plietar/light-control/hardware/light-control.kicad_pcb

## KiCad design hardware/light-control.kicad_pcb (2024-10-11)

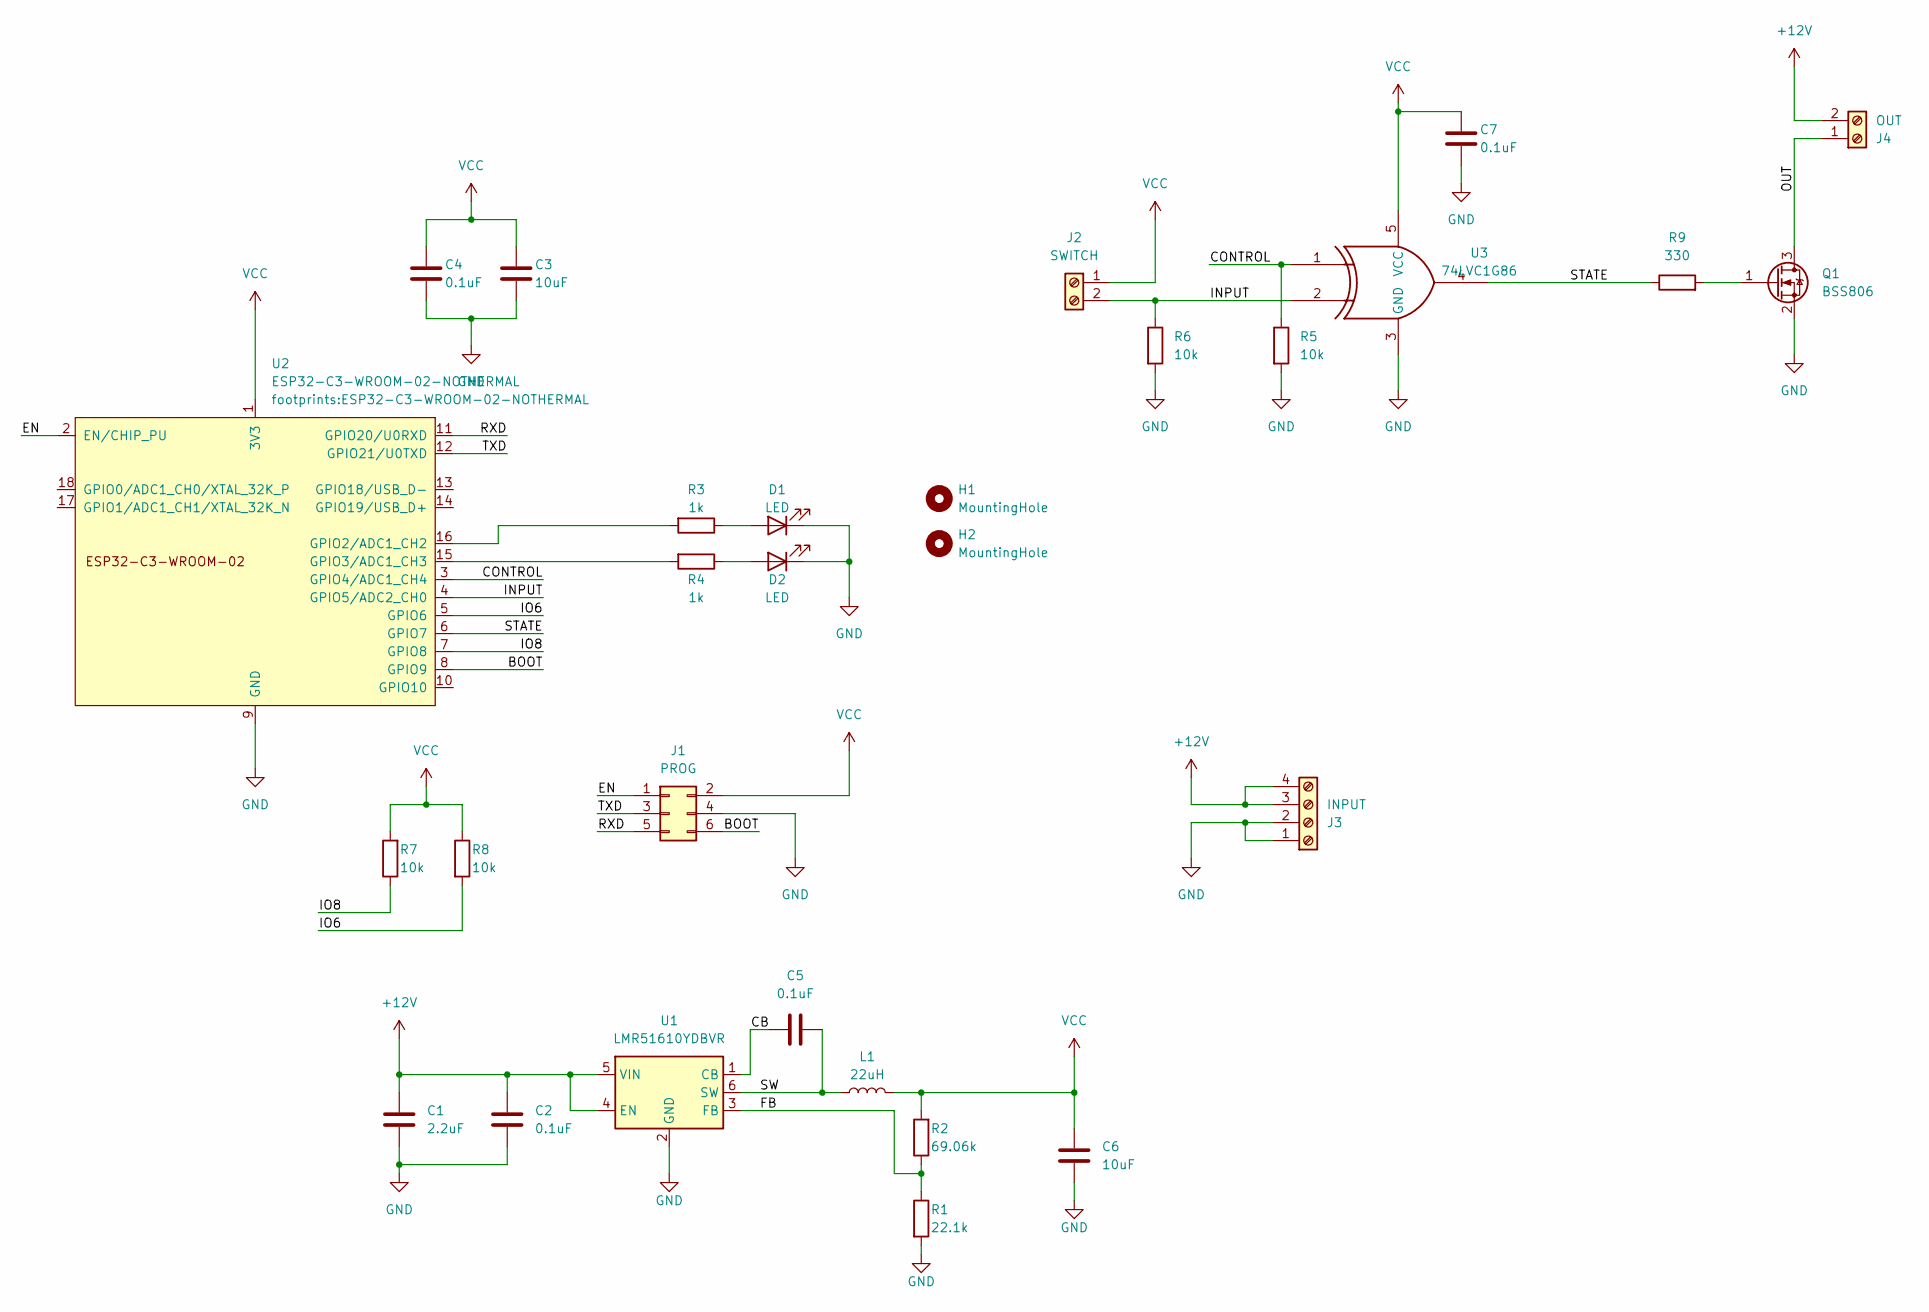
[picture p1: schematic light-control.kicad_sch]

Parts:
C1: 2.2uF; C_1206_3216Metric_Pad1.33x1.80mm_HandSolder
C2, C4, C5, C7: 0.1uF; C_1206_3216Metric_Pad1.33x1.80mm_HandSolder
C3: 10uF; C_1206_3216Metric_Pad1.33x1.80mm_HandSolder
C6: 10uF; C_1210_3225Metric_Pad1.33x2.70mm_HandSolder
D1, D2: LED; LED_1206_3216Metric_Pad1.42x1.75mm_HandSolder
H1, H2: MountingHole; MountingHole_2.2mm_M2
J1: PROG; Tag-Connect_TC2030-IDC-NL_2x03_P1.27mm_Vertical
J2: SWITCH; TerminalBlock_Phoenix_PT-1,5-2-3.5-H_1x02_P3.50mm_Horizontal
J3: INPUT; TerminalBlock_Phoenix_PT-1,5-4-3.5-H_1x04_P3.50mm_Horizontal
J4: OUT; TerminalBlock_Phoenix_PT-1,5-2-3.5-H_1x02_P3.50mm_Horizontal
L1: 22uH; L_TDK_VLS6045EX_VLS6045AF; Part number VLS6045EX-220M
Q1: BSS806; SOT-23_Handsoldering
R1: 22.1k; R_1206_3216Metric_Pad1.30x1.75mm_HandSolder
R2: 69.06k; R_1206_3216Metric_Pad1.30x1.75mm_HandSolder
R3, R4: 1k; R_1206_3216Metric_Pad1.30x1.75mm_HandSolder
R5, R6, R7, R8: 10k; R_1206_3216Metric_Pad1.30x1.75mm_HandSolder
R9: 330; R_1206_3216Metric_Pad1.30x1.75mm_HandSolder
U1: LMR51610YDBVR; SOT-23-6
U2: ESP32-C3-WROOM-02-NOTHERMAL
U3: 74LVC1G86; SOT-23-5_HandSoldering

Connections:
+12V: C1.1, C2.1, J3.3, J3.4, J4.2, U1.4 (EN), U1.5 (VIN)
/BOOT: J1.6, U2.8 (GPIO9)
/CB: C5.1, U1.1 (CB)
/CONTROL: R5.1, U2.3 (GPIO4/ADC1_CH4), U3.1
/EN: J1.1, U2.2 (EN/CHIP_PU)
/FB: R1.1, R2.1, U1.3 (FB)
/INPUT: J2.2, R6.1, U2.4 (GPIO5/ADC2_CH0), U3.2
/IO6: R8.2, U2.5 (GPIO6)
/IO8: R7.1, U2.7 (GPIO8)
/OUT: J4.1, Q1.3 (D)
/RXD: J1.5, U2.11 (GPIO20/U0RXD)
/STATE: R9.1, U2.6 (GPIO7), U3.4
/SW: C5.2, L1.1, U1.6 (SW)
/TXD: J1.3, U2.12 (GPIO21/U0TXD)
GND: C1.2, C2.2, C3.2, C4.2, C6.2, C7.2, D1.1 (K), D2.1 (K), J1.4, J3.1, J3.2, Q1.2 (S), R1.2, R5.2, R6.2, U1.2 (GND), U2.9 (GND), U3.3 (GND)
unnamed: D1.2 (A), R3.1
unnamed: D2.2 (A), R4.1
unnamed: Q1.1 (G), R9.2
unnamed: R3.2, U2.16 (GPIO2/ADC1_CH2)
unnamed: R4.2, U2.15 (GPIO3/ADC1_CH3)
VCC: C3.1, C4.1, C6.1, C7.1, J1.2, J2.1, L1.2, R2.2, R7.2, R8.1, U2.1 (3V3), U3.5 (VCC)

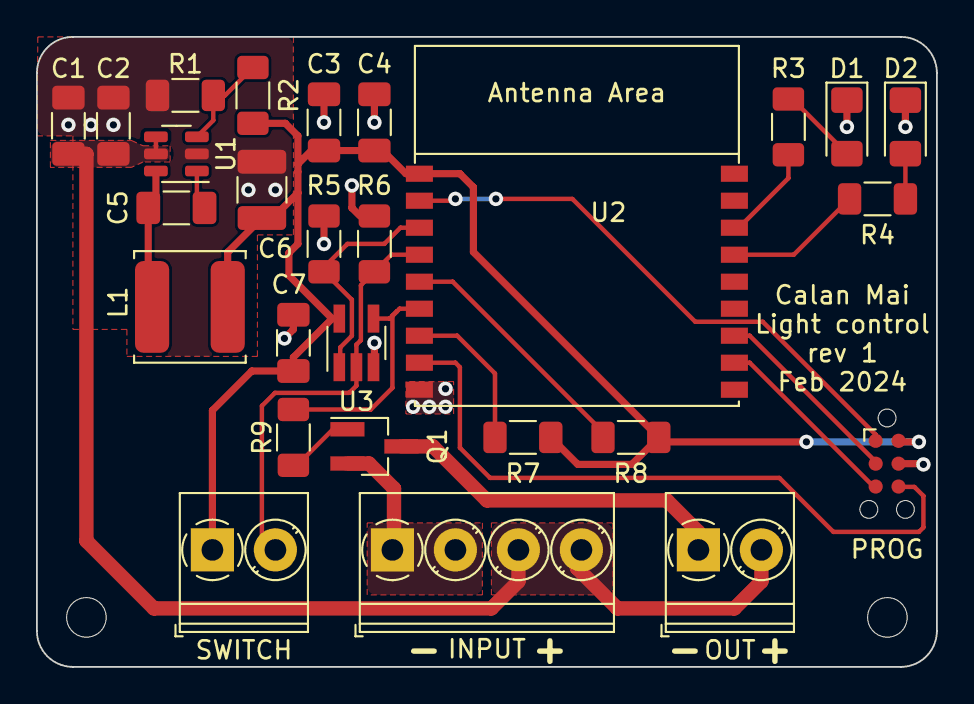
[picture p2: board light-control.kicad_pcb from above]

Board: 2 copper layers, 50.0 x 35.0 mm, 29 parts (0 on the bottom side), 21 nets.
