plietar/light-control/(commit log)

2024-03-03 Initial hardware revision
    [light-control.kicad_pcb, light-control.kicad_sch]
2024-10-11 Initial firmware version
    [light-control.kicad_pcb, light-control.kicad_sch, partitions.csv]
2024-10-11 Add new device
2024-10-11 Render schematics on CI.
